Eemac/droneSwarm/images/renderA.png

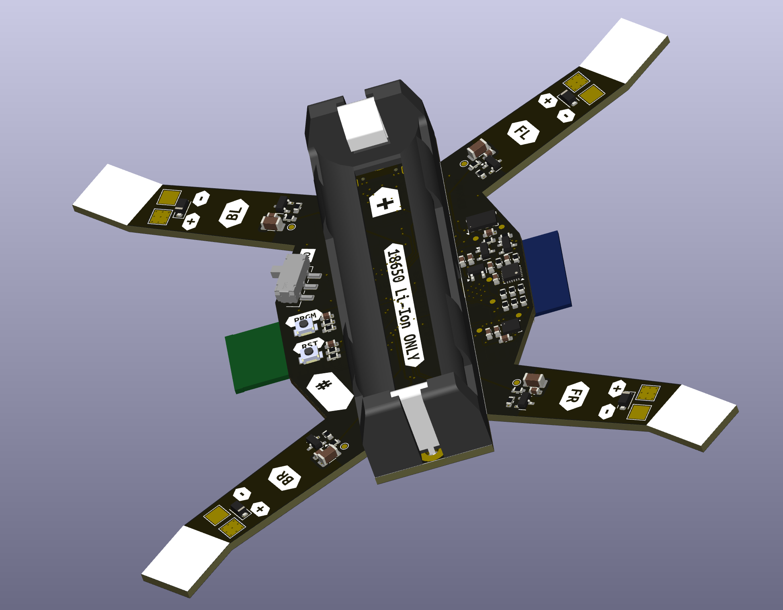
images/renderA.png
