Eemac/droneSwarm/images/real.JPG

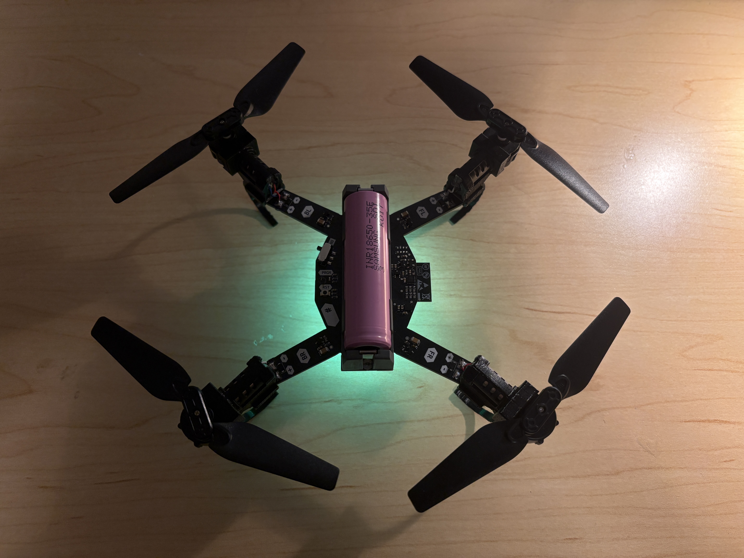
images/real.JPG
