Eemac/droneSwarm/README.md

# droneSwarm
Code and build log for a PCB quadcopter swarm.
