Eemac/droneSwarm/images/pcb.png

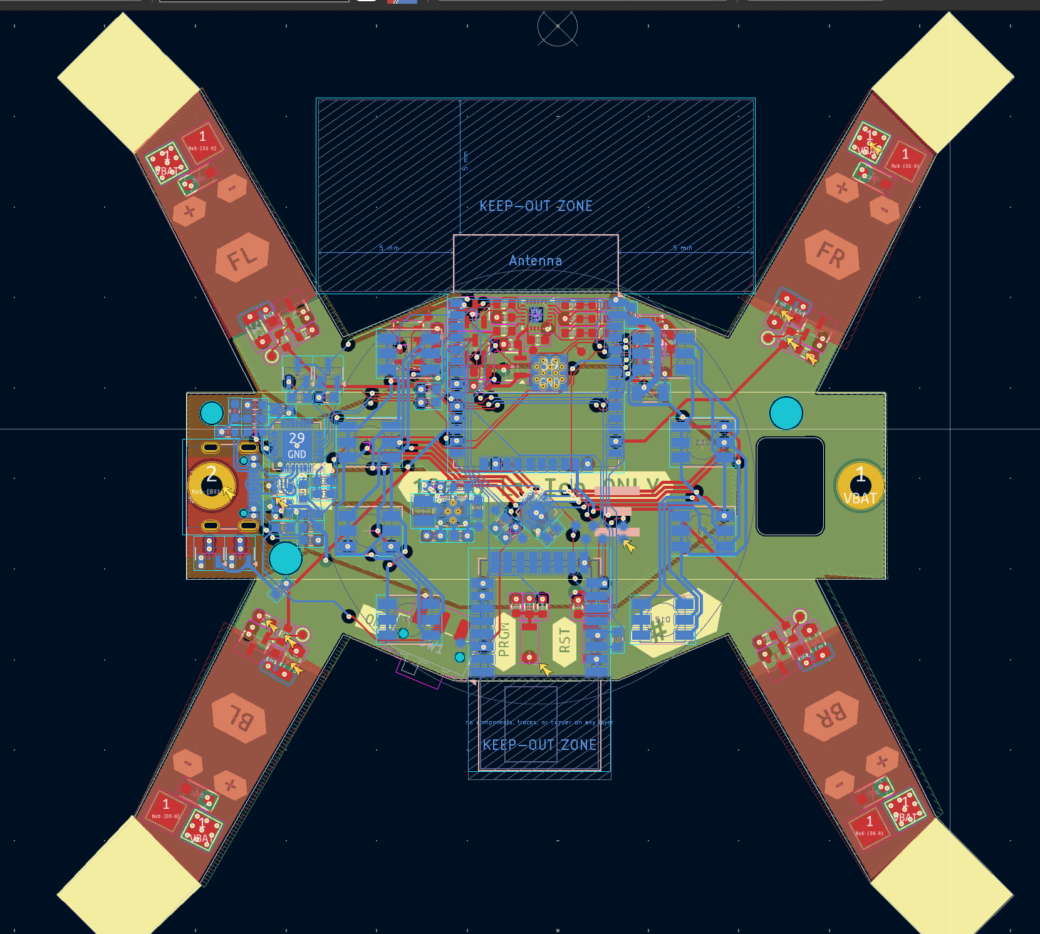
images/pcb.png
