Eemac/droneSwarm/images/render.png

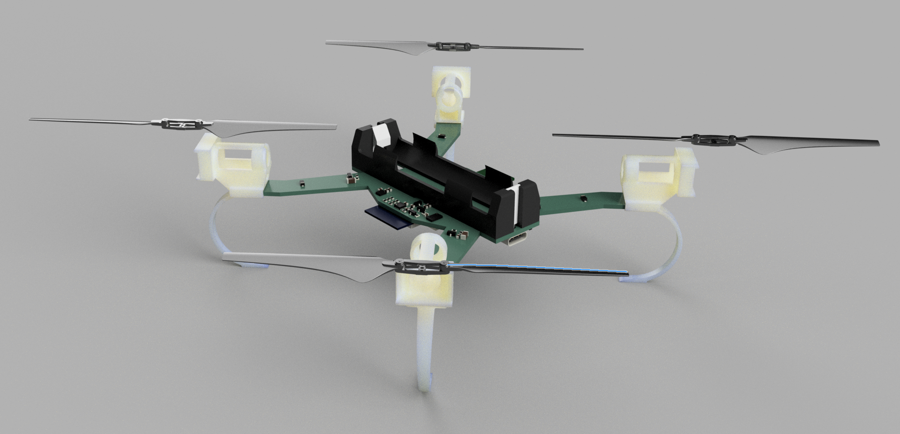
images/render.png
