Eemac/droneSwarm/Drone PCB/Drone.pdf

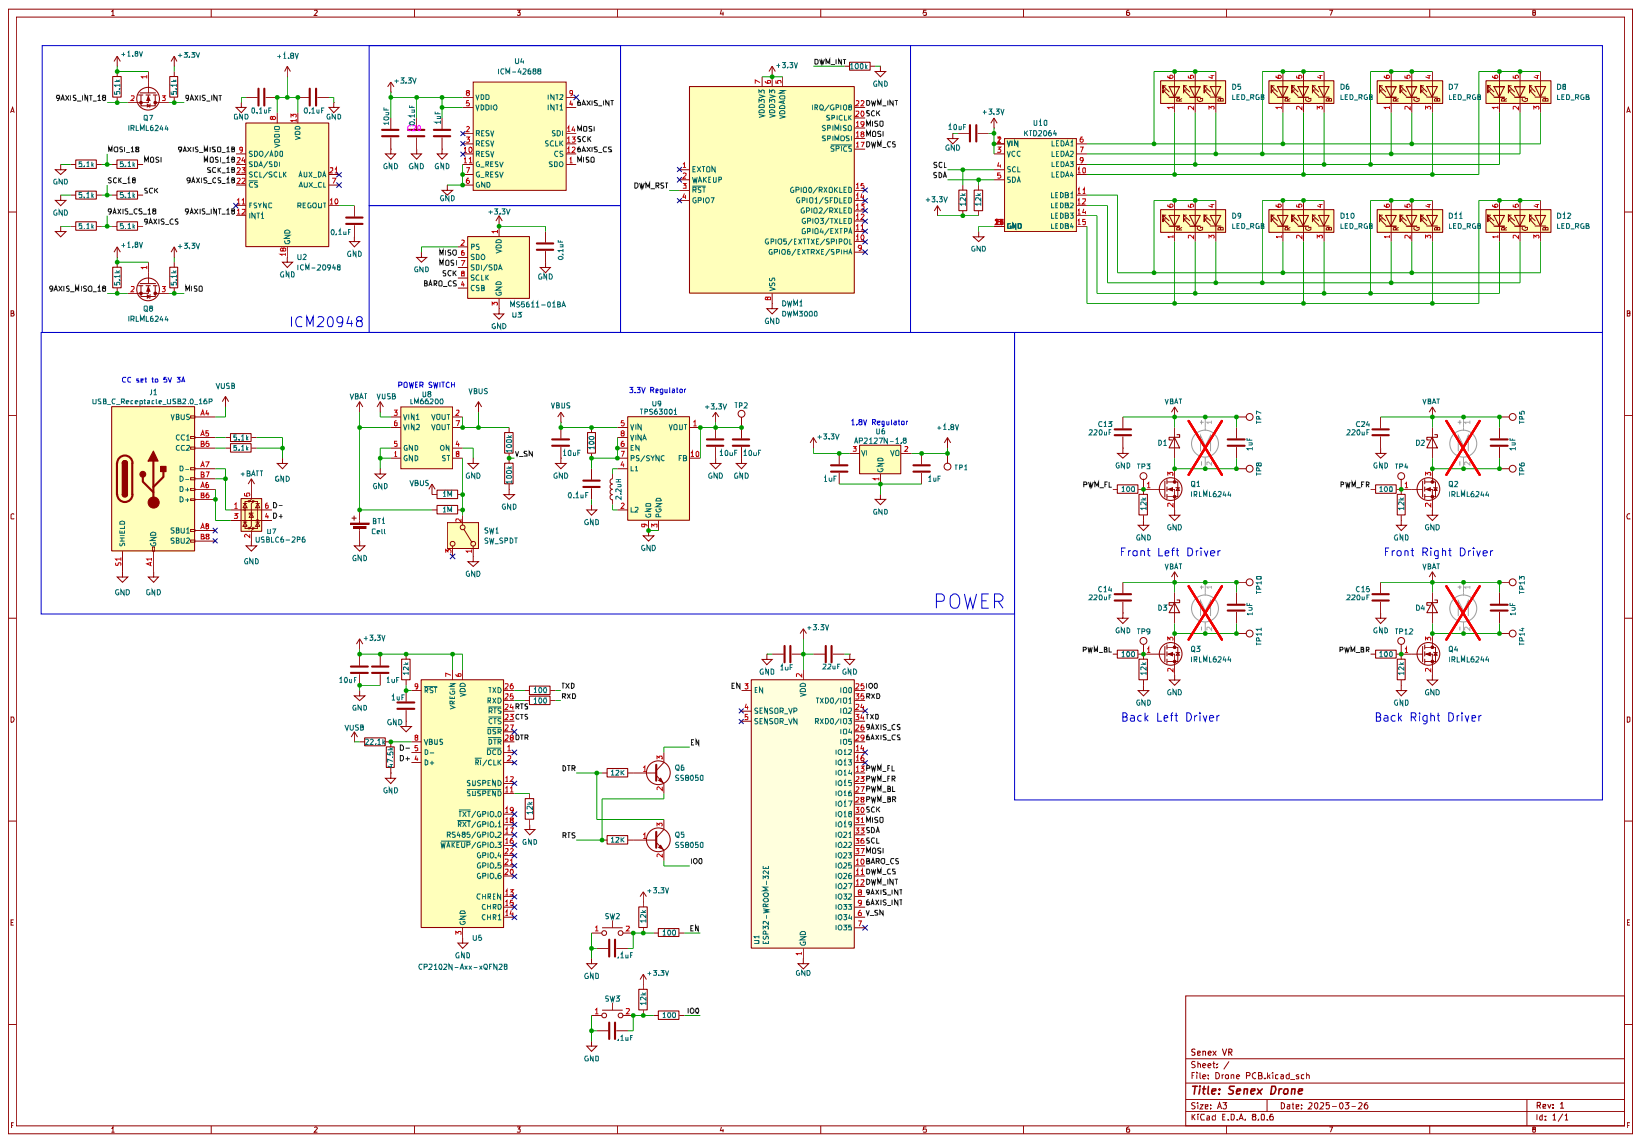
[picture p5: page 1]
