Eemac/droneSwarm/Drone PCB/Drone PCB.kicad_pcb

## KiCad design Drone PCB/Drone PCB.kicad_pcb (2026-03-31)

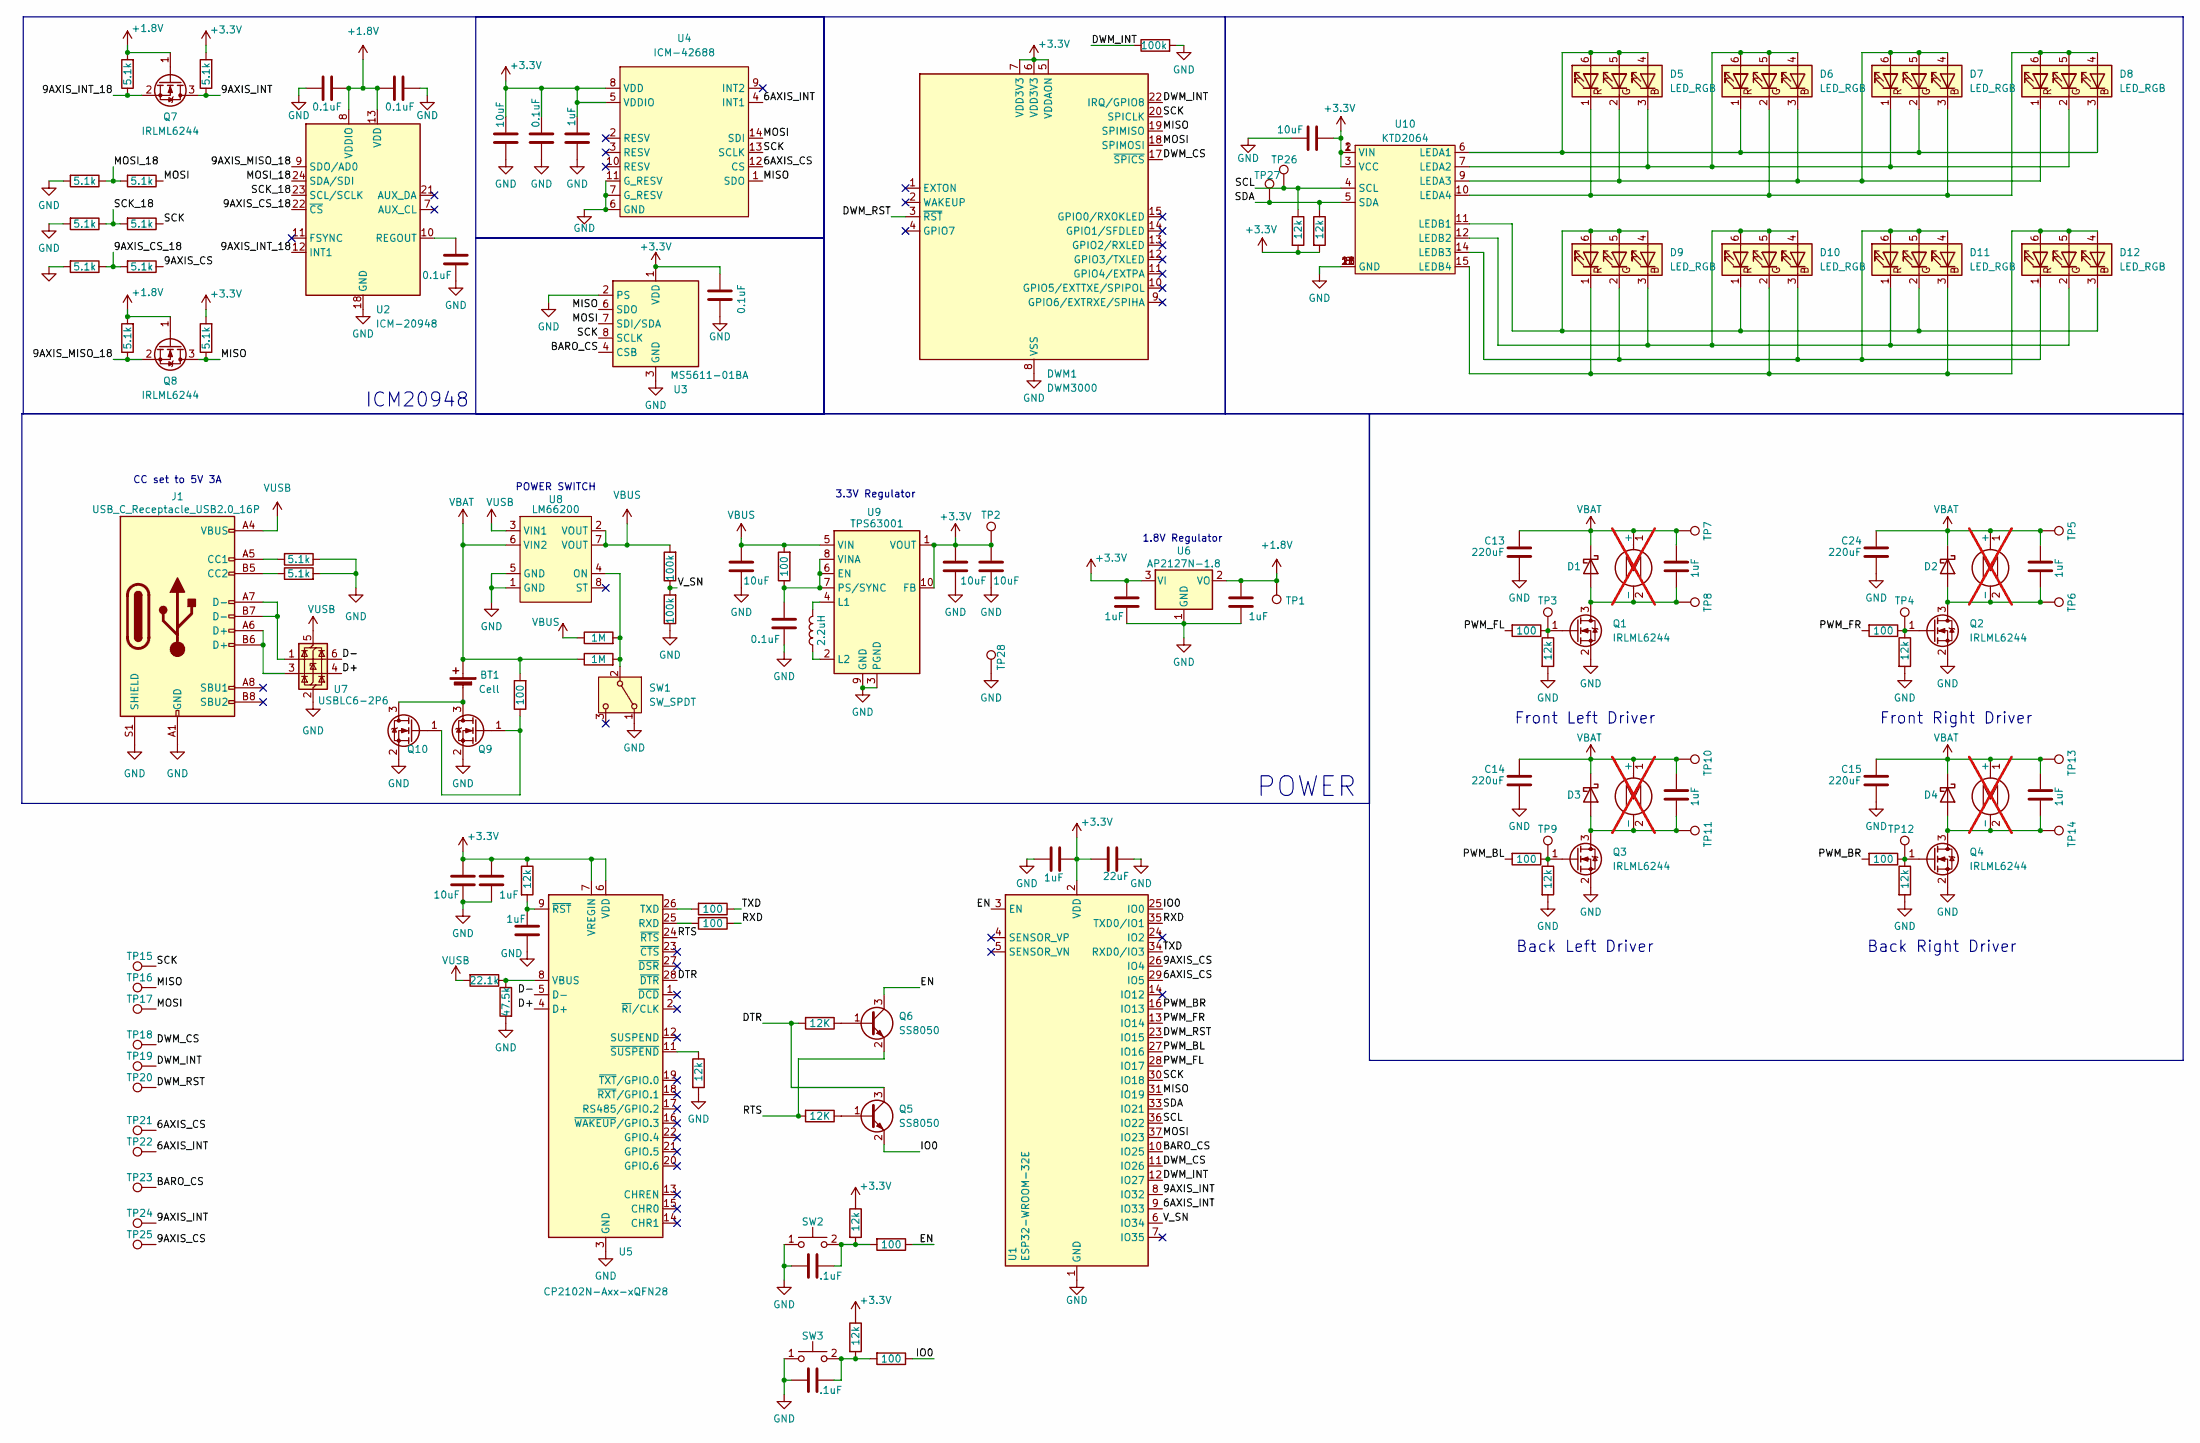
[picture p6: schematic Drone PCB.kicad_sch, Senex Drone]

Parts:
BT1: Cell; Battery Holder
C3, C8, C9, C10, C20, C31: 10uF; C_0603; MPN LMK107BBJ106KALT
C4, C5, C6, C22, C23, C26, C27, C28, C29, C30: 1uF; C_0603; MPN LMK107BBJ106KALT
C7, C16, C17, C18, C19, C21: 0.1uF; C_0603; MPN LMK107BBJ106KALT
C11, C12: .1uF; C_0603_1608Metric
C13, C14, C15, C24: 220uF; C_1206_3216Metric
C25: 22uF; C_1206_3216Metric
D1, D2, D3, D4: D_Schottky; D_SOD-123F
D5, D6, D7, D8, D9, D10, D11, D12: LED_RGB; LED_RGB_5050-6
DWM1: DWM3000; DWM1000
J1: USB_C_Receptacle_USB2.0_16P; USB_C_Receptacle_GCT_USB4105-xx-A_16P_TopMnt_Horizontal
L1: 2.2uH; L_1008_2520Metric
M1, M2, M3, M4: Motor_DC; not fitted
Q1, Q2, Q3, Q4, Q7, Q8, Q9, Q10: IRLML6244; SOT-23
Q5, Q6: SS8050; SOT-23
R1, R2, R18, R19, R20, R21, R22, R23, R24, R25, R26, R27: 5.1k; R_0603_1608Metric
R3, R4: 1M; R_0603_1608Metric
R5, R6: 12K; R_0603_1608Metric
R7, R11, R12, R14, R30, R32, R33, R35, R40, R41: 100; R_0603_1608Metric
R9, R13, R17, R29, R31, R34, R36, R38, R39, R42: 12k; R_0603_1608Metric
R15, R43, R44: 100k; R_0603_1608Metric
R28: 22.1k; R_0603_1608Metric
R37: 47.5k; R_0603_1608Metric
SW1: SW_SPDT; SW_SPDT_CK_JS102011SAQN
SW2, SW3: SW_Push_SPST_NO; SW_B3U-1000P_4.2x1.7mm; MPN B3U-1000P
TP1, TP2, TP15, TP16, TP17, TP18, TP19, TP20, TP21, TP22, TP23, TP24, TP25, TP26, TP27, TP28: TestPoint; TestPoint_Pad_D1mm
TP3, TP4, TP9, TP12: TestPoint; TestPoint_Pad_D1.0mm
TP5, TP6, TP7, TP8, TP10, TP11, TP13, TP14: TestPoint; TestPoint_Pad_3.0x3.0mm
U1: ESP32-WROOM-32E; ESP32-WROOM-32D
U2: ICM-20948; InvenSense_QFN-24_3x3mm_P0.4mm
U3: MS5611-01BA; LGA-8_3x5mm_P1.25mm
U4: ICM-42688; LGA-14_3x2.5mm_P0.5mm_LayoutBorder3x4y
U5: CP2102N-Axx-xQFN28; QFN-28-1EP_5x5mm_P0.5mm_EP3.35x3.35mm
U6: AP2127N-1.8; SOT-23
U7: USBLC6-2P6; SOT-666
U8: LM66200; SOT-5X3
U9: TPS63001; Texas_DRC0010J_ThermalVias
U10: KTD2064; QFN-20-1EP_3x3mm_P0.4mm_EP1.65x1.65mm

Connections:
+1.8V: C5.1, C17.1, C18.2, Q7.1 (G), Q8.1 (G), R24.2, R26.2, TP1.1, U2.8 (VDDIO), U2.13 (VDD), U6.2 (VO)
+3.3V: C3.1, C4.1, C6.1, C9.1, C10.1, C19.2, C20.1, C21.1, C22.1, C23.2, C25.1, C31.2, DWM1.5 (VDDAON), DWM1.6 (VDD3V3), DWM1.7 (VDD3V3), R9.1, R13.1, R17.1, R25.2, R27.2, R38.2, R39.2, TP2.1, U1.2 (VDD), U3.1 (VDD), U4.5 (VDDIO), U4.8 (VDD), U5.6 (VDD), U5.7 (VREGIN), U6.3 (VI), U9.1 (VOUT), U9.10 (FB), U10.1 (VIN), U10.2 (VIN), U10.3 (VCC)
/6AXIS_CS: TP21.1, U1.29 (IO5), U4.12 (CS)
/6AXIS_INT: TP22.1, U1.9 (IO33), U4.4 (INT1)
/9AXIS_CS: R23.1, TP25.1, U1.26 (IO4)
/9AXIS_CS_18: R22.1, R23.2, U2.22 (~CS)
/9AXIS_INT: Q7.3 (D), R25.1, TP24.1, U1.8 (IO32)
/9AXIS_INT_18: Q7.2 (S), R24.1, U2.12 (INT1)
/9AXIS_MISO_18: Q8.2 (S), R26.1, U2.9 (SDO/AD0)
/BARO_CS: TP23.1, U1.10 (IO25), U3.4 (CSB), U3.5 (CSB)
/D+: U5.4 (D+), U7.4 (I/O2)
/D-: U5.5 (D-), U7.6 (I/O1)
/DTR: Q5.3 (C), R5.2, U5.28 (~DTR)
/DWM_CS: DWM1.17 (~SPICS), TP18.1, U1.11 (IO26)
/DWM_INT: DWM1.22 (IRQ/GPIO8), R15.1, TP19.1, U1.12 (IO27)
/DWM_RST: DWM1.3 (~RST), TP20.1, U1.23 (IO15)
/EN: Q6.3 (C), R40.1, U1.3 (EN)
/IO0: Q5.2 (E), R41.1, U1.25 (IO0)
/MISO: DWM1.19 (SPIMISO), Q8.3 (D), R27.1, TP16.1, U1.31 (IO19), U3.6 (SDO), U4.1 (SDO)
/MOSI: DWM1.18 (SPIMOSI), R19.1, TP17.1, U1.37 (IO23), U3.7 (SDI/SDA), U4.14 (SDI)
/MOSI_18: R18.1, R19.2, U2.24 (SDA/SDI)
/PWM_BL: R32.2, U1.27 (IO16)
/PWM_BR: R35.2, U1.16 (IO13)
/PWM_FL: R33.2, U1.28 (IO17)
/PWM_FR: R30.2, U1.13 (IO14)
/RTS: Q6.2 (E), R6.2, U5.24 (~RTS)
/RXD: R14.1, U1.35 (TXD0/IO1)
/SCK: DWM1.20 (SPICLK), R21.1, TP15.1, U1.30 (IO18), U3.8 (SCLK), U4.13 (SCLK)
/SCK_18: R20.1, R21.2, U2.23 (SCL/SCLK)
/SCL: R38.1, TP26.1, U1.36 (IO22), U10.4 (SCL)
/SDA: R39.1, TP27.1, U1.33 (IO21), U10.5 (SDA)
/TXD: R11.1, U1.34 (RXD0/IO3)
/V_SN: R43.1, R44.2, U1.6 (IO34)
GND: C3.2, C4.2, C5.2, C6.2, C7.2, C8.2, C9.2, C10.2, C11.1, C12.1, C13.1, C14.1, C15.1, C16.2, C17.2, C18.1, C19.1, C20.2, C21.2, C22.2, C23.1, C24.1, C25.2, C26.2, C31.1, DWM1.8 (VSS), DWM1.16 (VSS), DWM1.21 (VSS), DWM1.23 (VSS), DWM1.24 (VSS), J1.A1 (GND), J1.A12 (GND), J1.B1 (GND), J1.B12 (GND), J1.S1 (SHIELD), Q1.2 (S), Q2.2 (S), Q3.2 (S), Q4.2 (S), Q9.2 (S), Q10.2 (S), R1.1, R2.2, R15.2, R18.2, R20.2, R22.2, R29.2, R31.2, R34.2, R36.2, R37.2, R42.2, R44.1, SW1.1 (A), SW2.1, SW3.1, TP28.1, U1.1 (GND), U1.15 (GND), U1.38 (GND), U1.39 (GND), U2.18 (GND), U2.20 (GND), U3.2 (PS), U3.3 (GND), U4.6 (GND), U4.7 (G_RESV), U4.11 (G_RESV), U5.3 (GND), U5.29 (GND), U6.1 (GND), U7.2 (GND), U8.1 (GND), U8.5 (GND), U9.3 (PGND), U9.9 (GND), U9.11 (PGND), U10.8 (GND), U10.13 (GND), U10.18 (GND), U10.21 (GND)
unnamed: BT1.2 (-), Q9.3 (D), Q10.3 (D)
unnamed: C11.2, R13.2, R40.2, SW2.2
unnamed: C12.2, R9.2, R41.2, SW3.2
unnamed: C27.1, D1.2 (A), M1.2 (-), Q1.3 (D), TP8.1
unnamed: C29.1, D2.2 (A), M2.2 (-), Q2.3 (D), TP6.1
unnamed: C28.1, D3.2 (A), M3.2 (-), Q3.3 (D), TP11.1
unnamed: C30.1, D4.2 (A), M4.2 (-), Q4.3 (D), TP14.1
unnamed: D5.4 (BA), D5.5 (GA), D5.6 (RA), D6.1 (RK), D7.2 (GK), D8.3 (BK), U10.6 (LEDA1)
unnamed: D5.3 (BK), D6.4 (BA), D6.5 (GA), D6.6 (RA), D7.1 (RK), D8.2 (GK), U10.7 (LEDA2)
unnamed: D5.2 (GK), D6.3 (BK), D7.4 (BA), D7.5 (GA), D7.6 (RA), D8.1 (RK), U10.9 (LEDA3)
unnamed: D5.1 (RK), D6.2 (GK), D7.3 (BK), D8.4 (BA), D8.5 (GA), D8.6 (RA), U10.10 (LEDA4)
unnamed: D9.3 (BK), D10.4 (BA), D10.5 (GA), D10.6 (RA), D11.1 (RK), D12.2 (GK), U10.12 (LEDB2)
unnamed: D9.2 (GK), D10.3 (BK), D11.4 (BA), D11.5 (GA), D11.6 (RA), D12.1 (RK), U10.14 (LEDB3)
unnamed: D9.1 (RK), D10.2 (GK), D11.3 (BK), D12.4 (BA), D12.5 (GA), D12.6 (RA), U10.15 (LEDB4)
unnamed: D9.4 (BA), D9.5 (GA), D9.6 (RA), D10.1 (RK), D11.2 (GK), D12.3 (BK), U10.11 (LEDB1)
unnamed: J1.A5 (CC1), R1.2
unnamed: J1.B5 (CC2), R2.1
unnamed: J1.A6 (D+), J1.B6 (D+), U7.3 (I/O2)
unnamed: J1.A7 (D-), J1.B7 (D-), U7.1 (I/O1)
unnamed: Q1.1 (G), R29.1, R33.1, TP3.1
unnamed: Q2.1 (G), R30.1, R31.1, TP4.1
unnamed: Q3.1 (G), R32.1, R34.1, TP9.1
unnamed: Q4.1 (G), R35.1, R36.1, TP12.1
unnamed: Q5.1 (B), R6.1
unnamed: Q6.1 (B), R5.1
unnamed: Q9.1 (G), Q10.1 (G), R7.1
unnamed: R3.2, R4.2, SW1.2 (B), U8.4 (ON)
unnamed: C16.1, U2.10 (REGOUT)
unnamed: R14.2, U5.25 (RXD)
unnamed: R11.2, U5.26 (TXD)
unnamed: R28.1, R37.1, U5.8 (VBUS)
unnamed: C26.1, R17.2, U5.9 (~RST)
unnamed: R42.1, U5.11 (~SUSPEND)
unnamed: C7.1, R12.1, U9.6 (EN), U9.7 (PS/SYNC), U9.8 (VINA)
unnamed: L1.2, U9.4 (L1)
unnamed: L1.1, U9.2 (L2)
VBAT: BT1.1 (+), C13.2, C14.2, C15.2, C24.2, C27.2, C28.2, C29.2, C30.2, D1.1 (K), D2.1 (K), D3.1 (K), D4.1 (K), M1.1 (+), M2.1 (+), M3.1 (+), M4.1 (+), R4.1, R7.2, TP5.1, TP7.1, TP10.1, TP13.1, U8.6 (VIN2)
VBUS: C8.1, R3.1, R12.2, R43.2, U8.2 (VOUT), U8.7 (VOUT), U9.5 (VIN)
VUSB: J1.A4 (VBUS), J1.A9 (VBUS), J1.B4 (VBUS), J1.B9 (VBUS), R28.2, U7.5 (VBUS), U8.3 (VIN1)

Notes on the sheet:
Front Left Driver
Back Right Driver
Front Right Driver
ICM20948
Back Left Driver
POWER
POWER SWITCH
3.3V Regulator
1.8V Regulator
CC set to 5V 3A

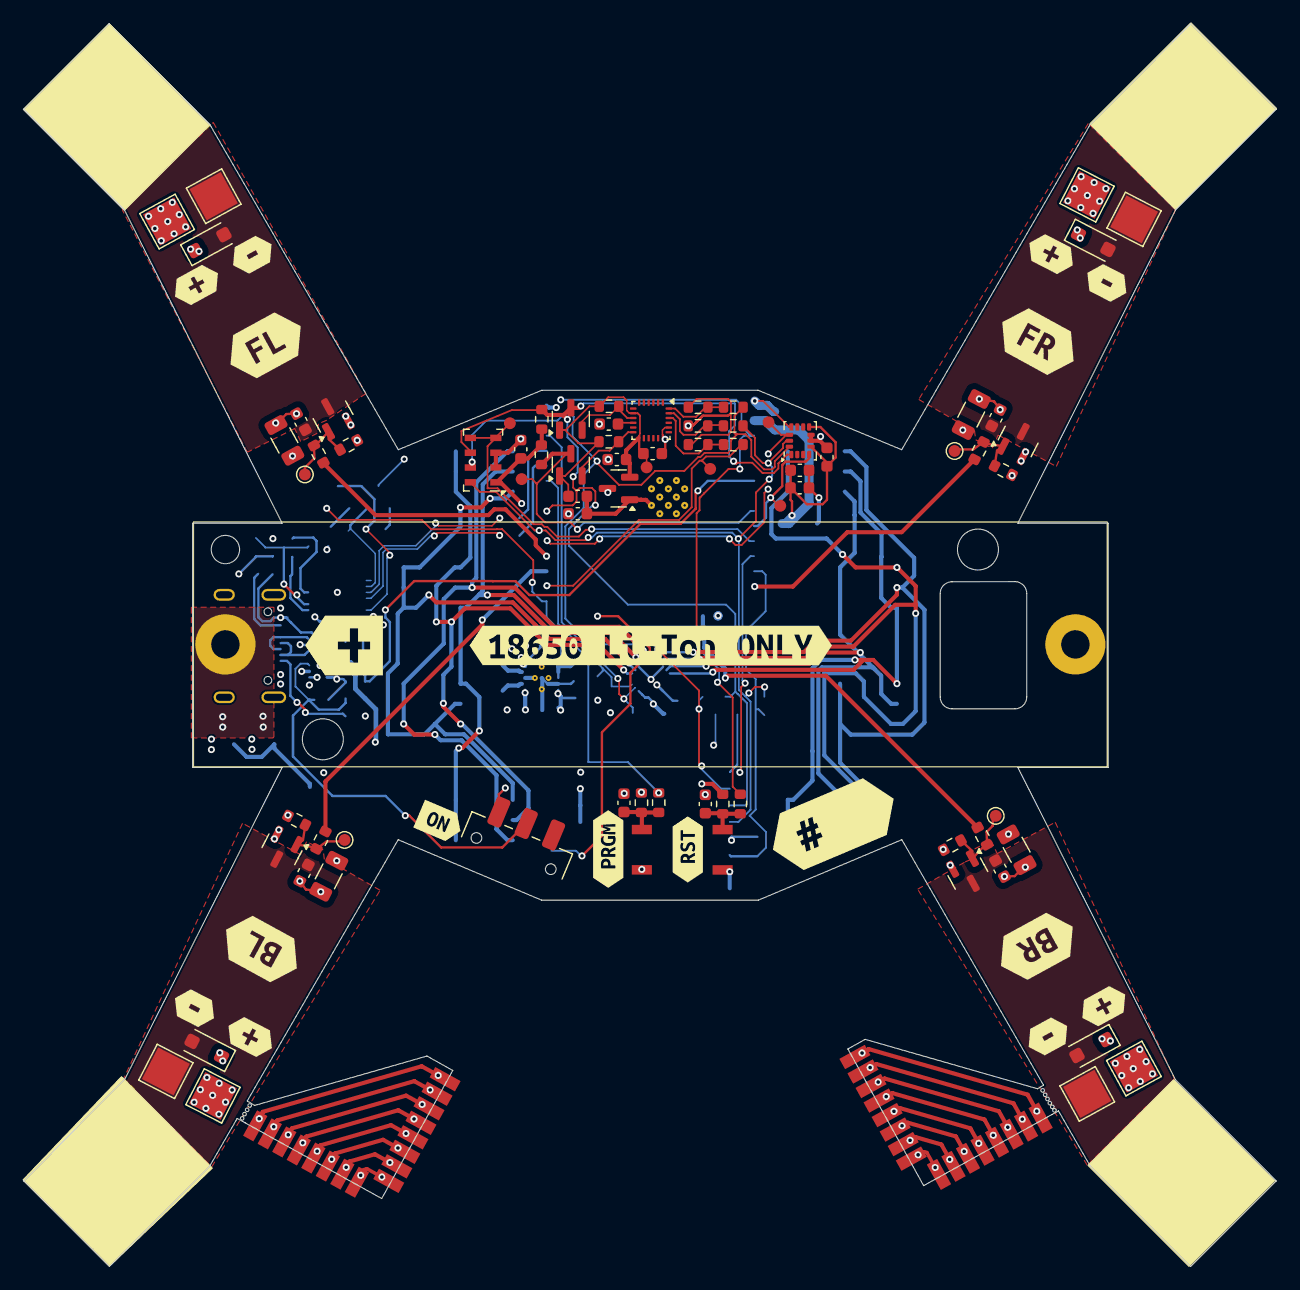
[picture p7: board Drone PCB.kicad_pcb from above]

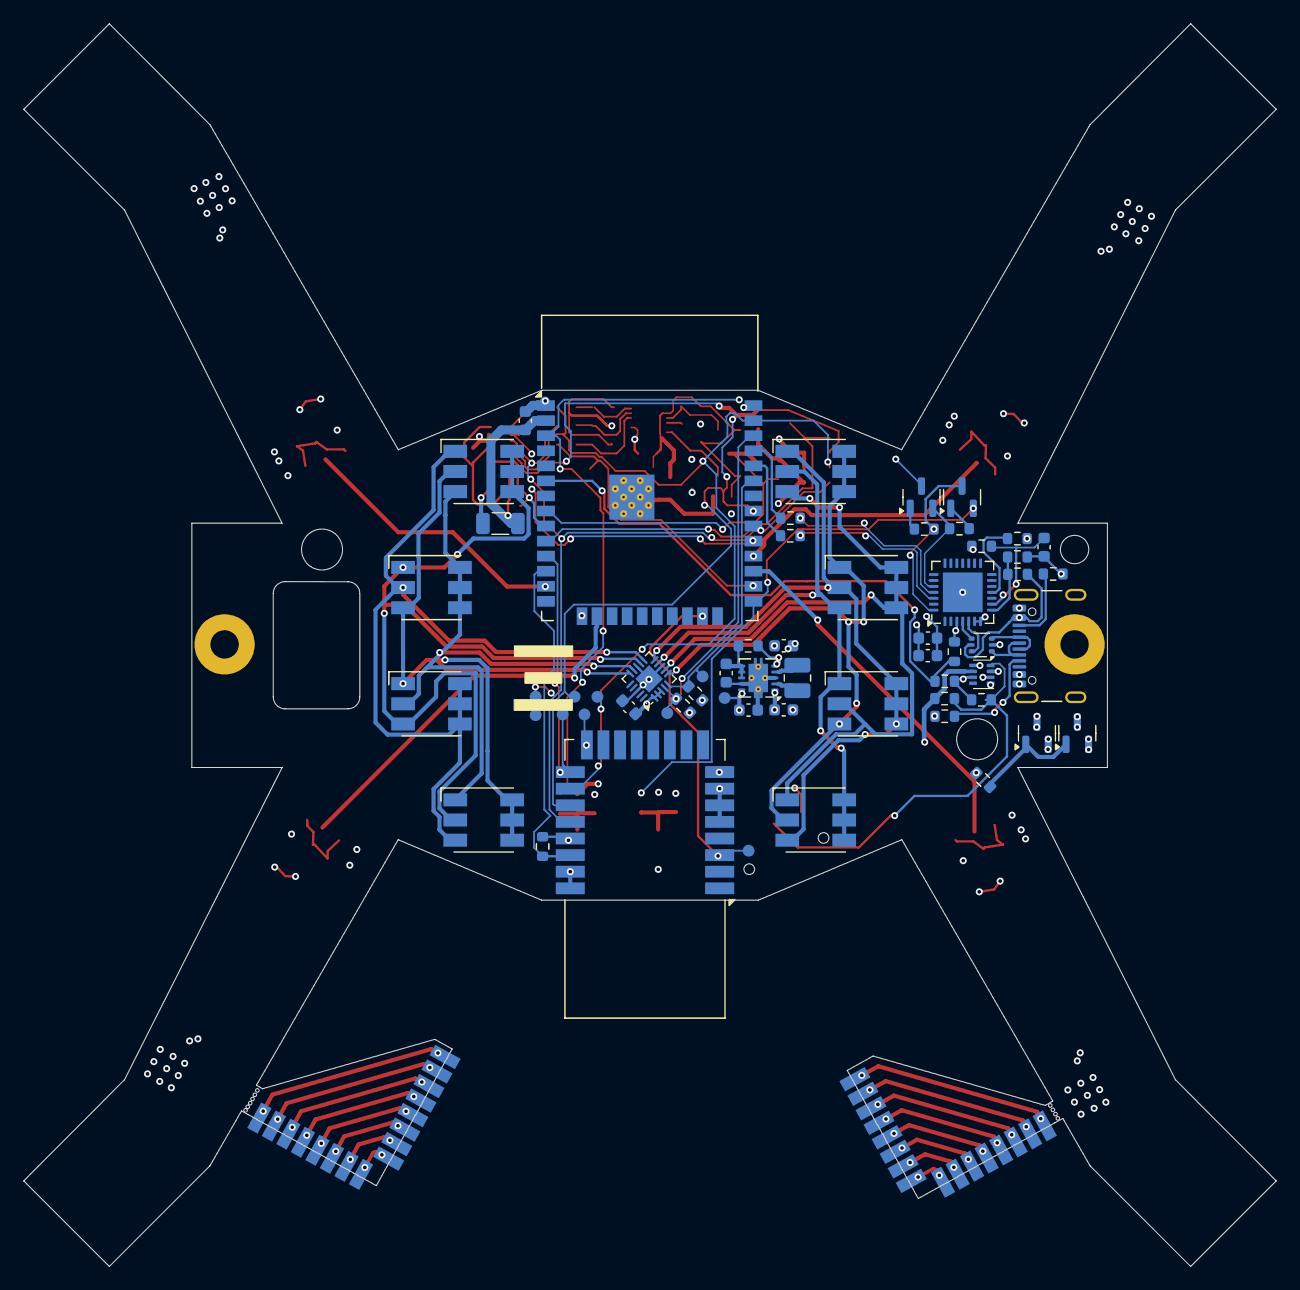
[picture p8: board Drone PCB.kicad_pcb from below]

Board: 4 copper layers, 105.6 x 104.8 mm, 155 parts (60 on the bottom side), 73 nets.

Other parts of the board:
kibuzzard-682A6A3A: G***; kibuzzard-682A6A3A
kibuzzard-682A6E86: G***; kibuzzard-682A6E86
kibuzzard-682A6EE1: G***; kibuzzard-682A6EE1
kibuzzard-682A6EFD: G***; kibuzzard-682A6EFD
kibuzzard-682A64DA: G***; kibuzzard-682A64DA
kibuzzard-682A72B2: G***; kibuzzard-682A72B2
kibuzzard-682A717E: G***; kibuzzard-682A717E
kibuzzard-682A719B: G***; kibuzzard-682A719B
kibuzzard-682A6346: G***; kibuzzard-682A6346
kibuzzard-682A6523, kibuzzard-682A6523#2, kibuzzard-682A6523#3, kibuzzard-682A6523#4: G***; kibuzzard-682A6523
kibuzzard-682A6594, kibuzzard-682A6594#2, kibuzzard-682A6594#3, kibuzzard-682A6594#4: G***; kibuzzard-682A6594
kibuzzard-682A7152: G***; kibuzzard-682A7152
